trezm/dotty/docs/battery-40x30x8/bottom-loading-render.png

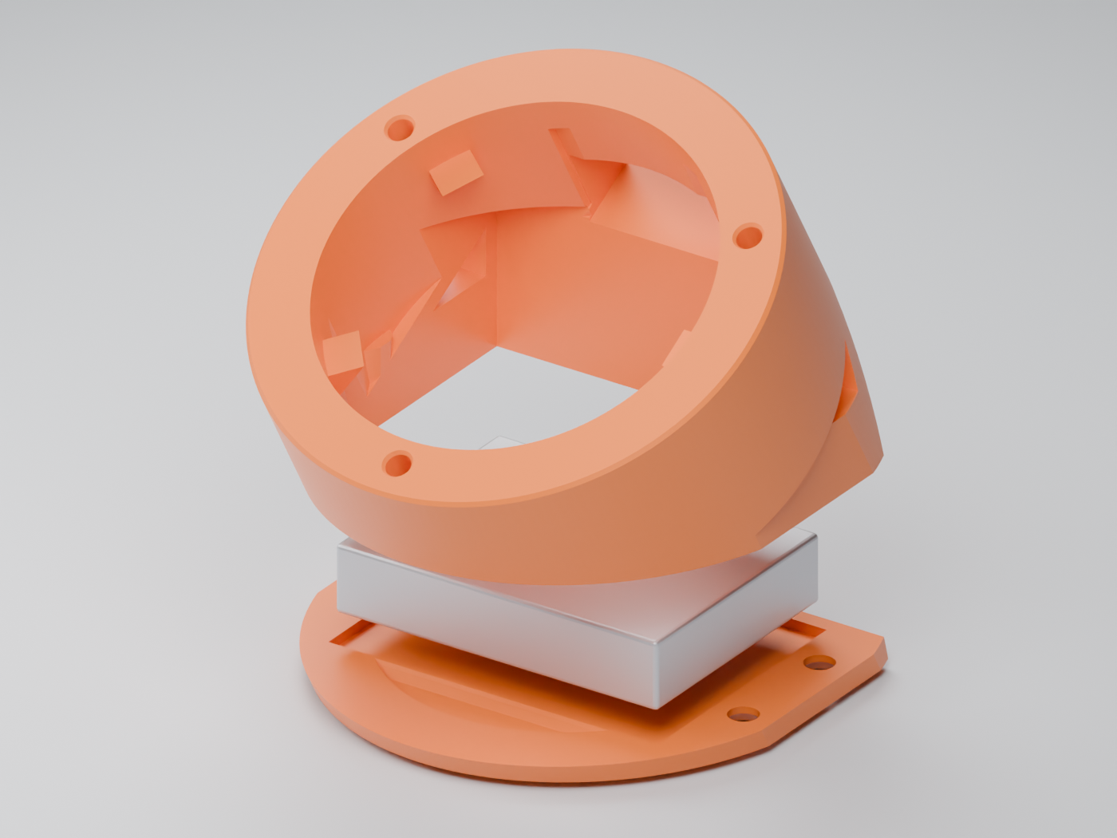
docs/battery-40x30x8/bottom-loading-render.png
