trezm/dotty/docs/battery-40x30x8/cutaway.png

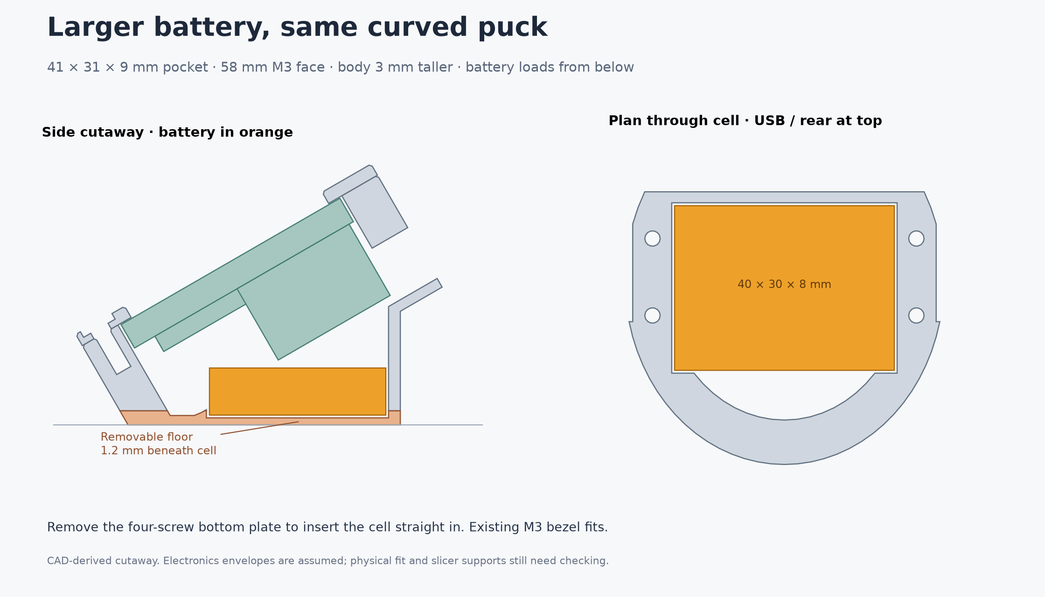
docs/battery-40x30x8/cutaway.png
