trezm/dotty/docs/battery-40x30x8/front-render.png

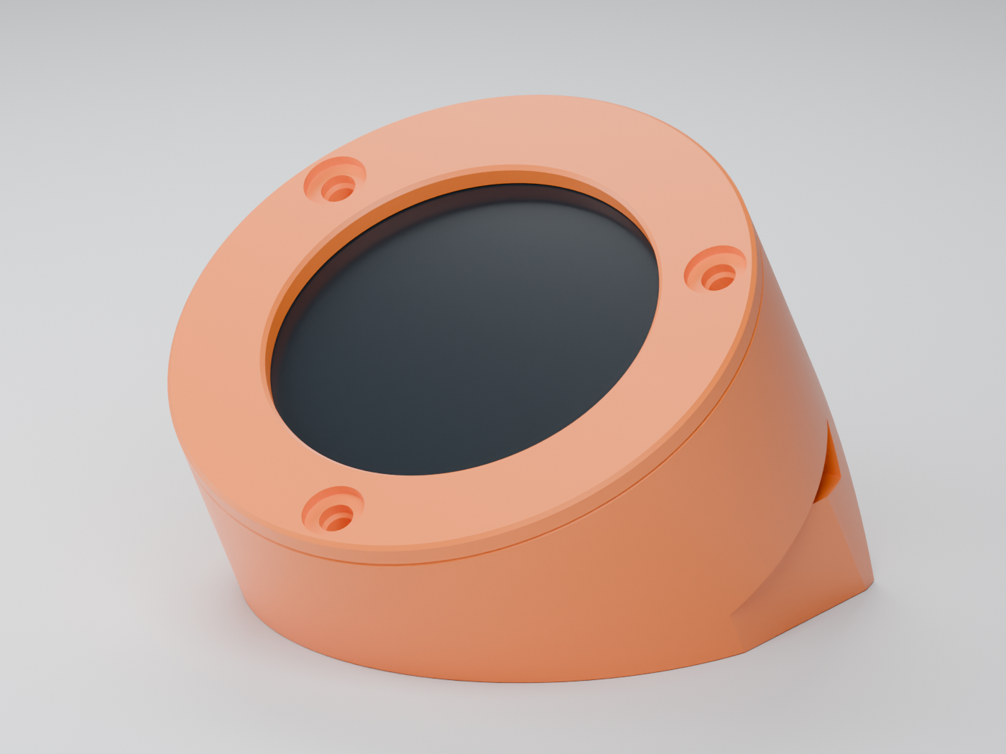
docs/battery-40x30x8/front-render.png
