trezm/dotty/docs/battery-disk/bottom-loading-render.png

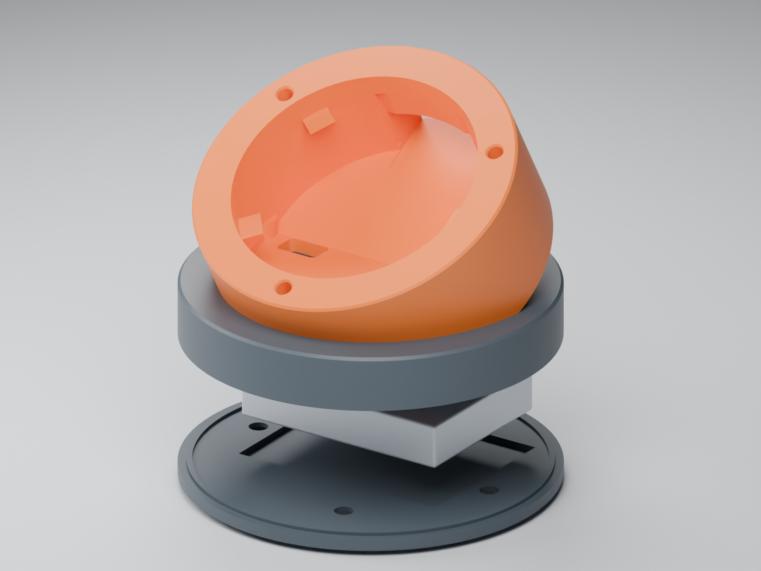
docs/battery-disk/bottom-loading-render.png
