trezm/dotty/docs/battery-disk/countersink-section.png

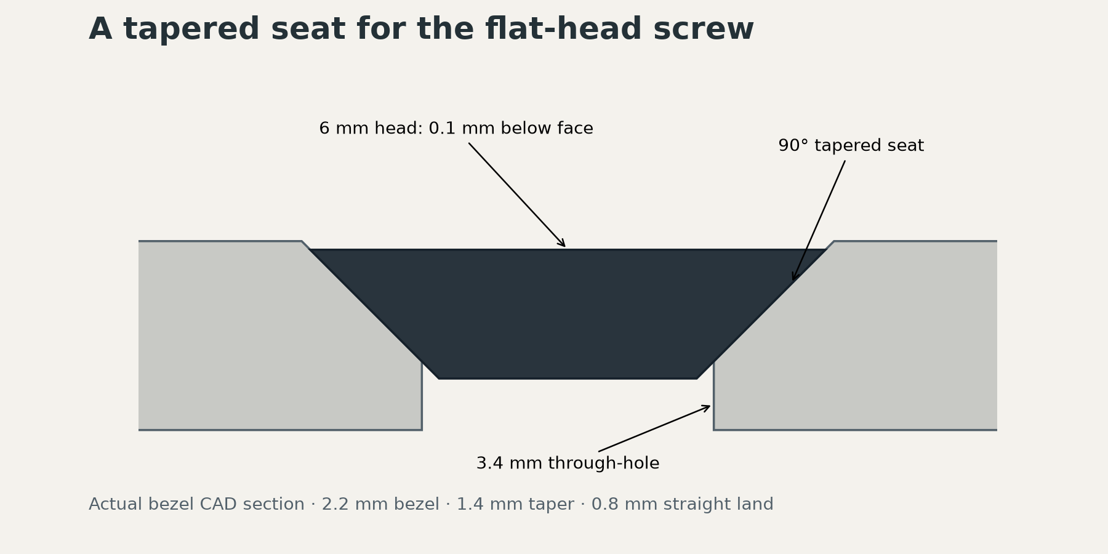
docs/battery-disk/countersink-section.png
