trezm/dotty/docs/battery-disk/countersink-stl-closeup.png

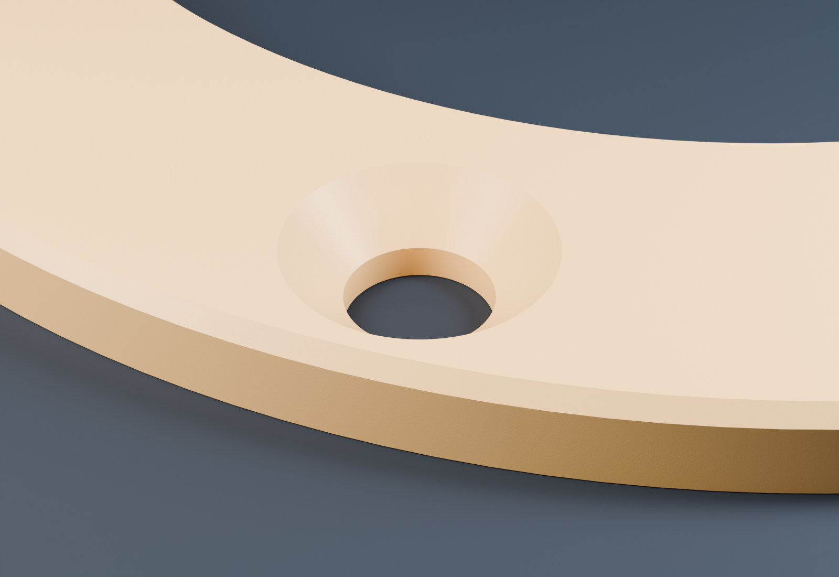
docs/battery-disk/countersink-stl-closeup.png
