trezm/dotty/docs/battery-disk/cutaway.png

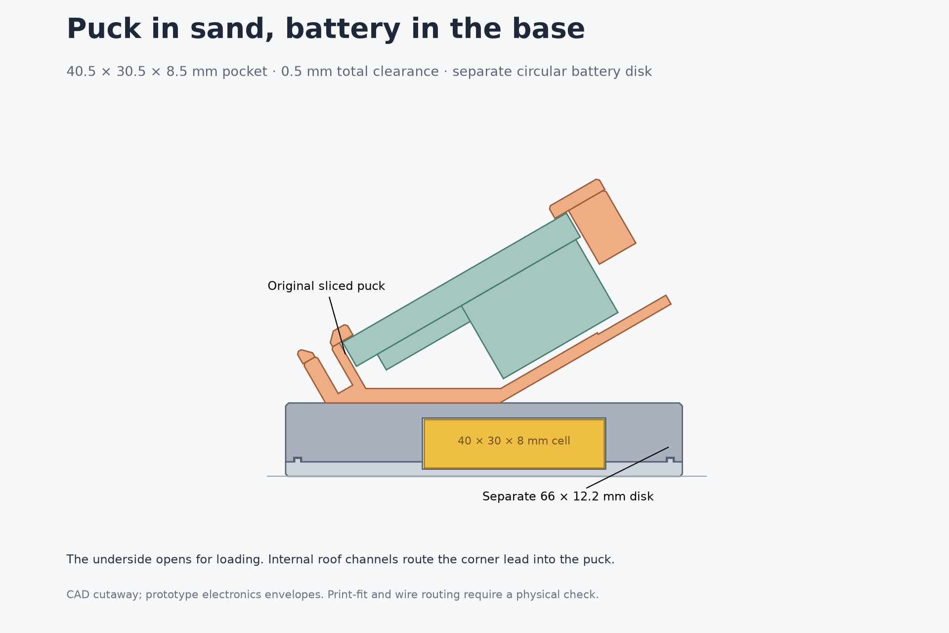
docs/battery-disk/cutaway.png
