trezm/dotty/docs/battery-disk/front-render.png

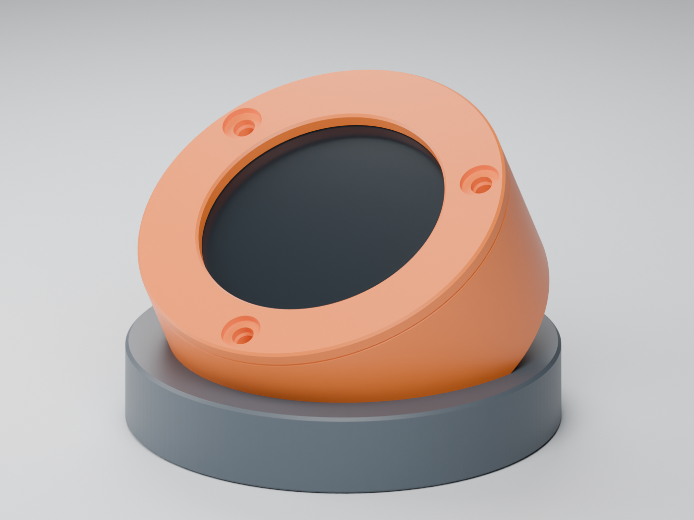
docs/battery-disk/front-render.png
