trezm/dotty/docs/battery-disk/side-render.png

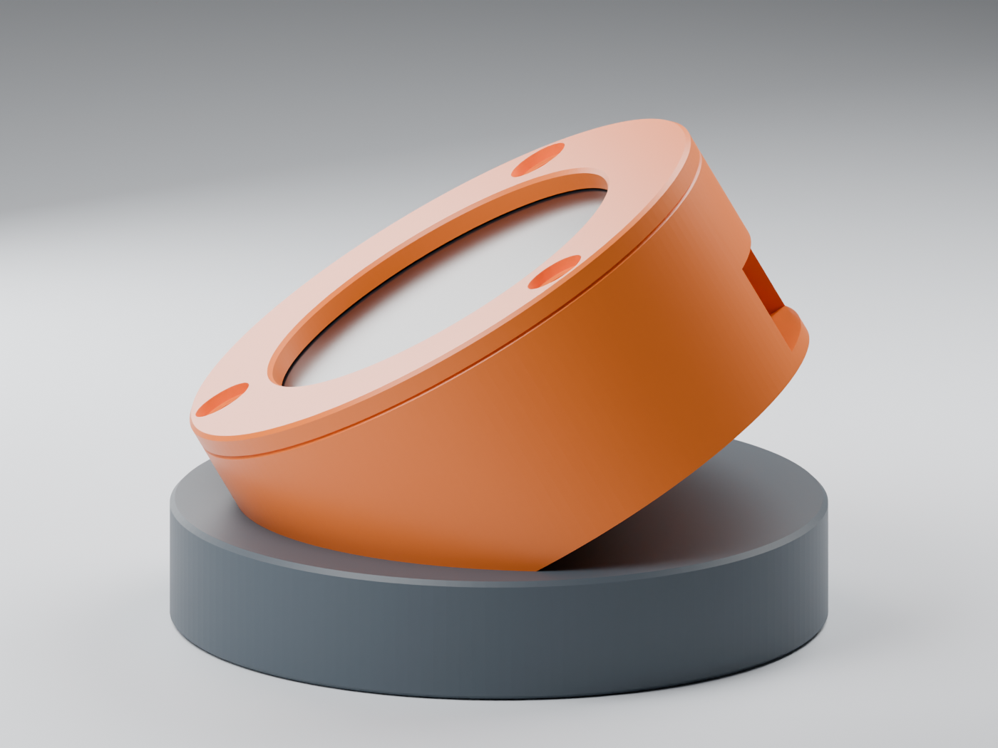
docs/battery-disk/side-render.png
