trezm/dotty/docs/battery-study/compact-base.png

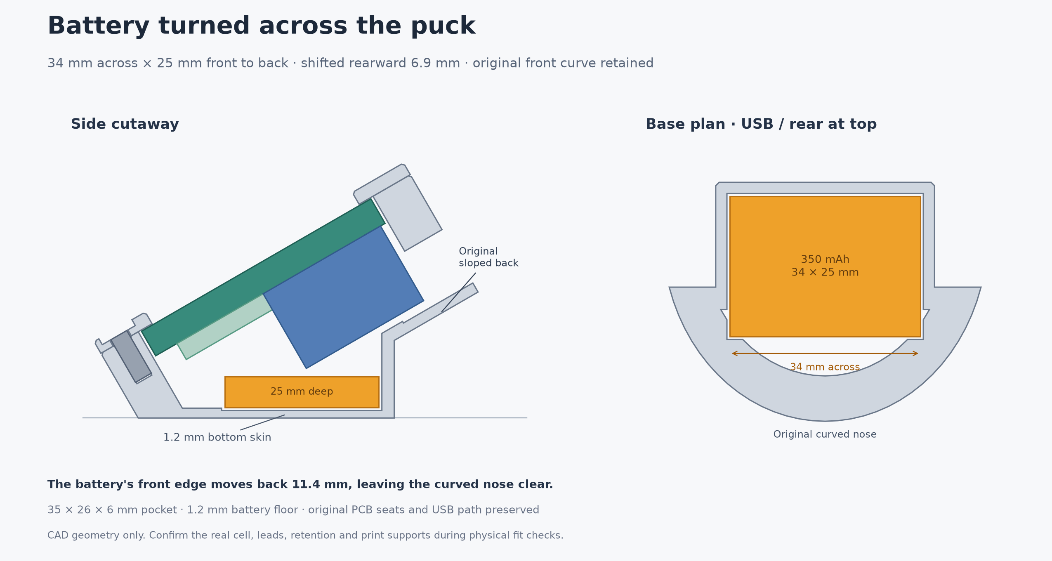
docs/battery-study/compact-base.png
