trezm/dotty/docs/battery-study/crosswise-front-render.png

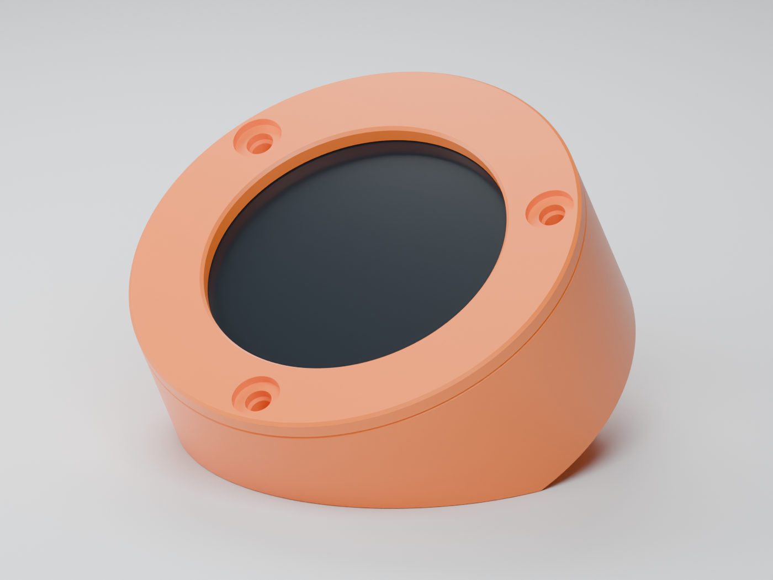
docs/battery-study/crosswise-front-render.png
