trezm/dotty/docs/battery-study/crosswise-open-render.png

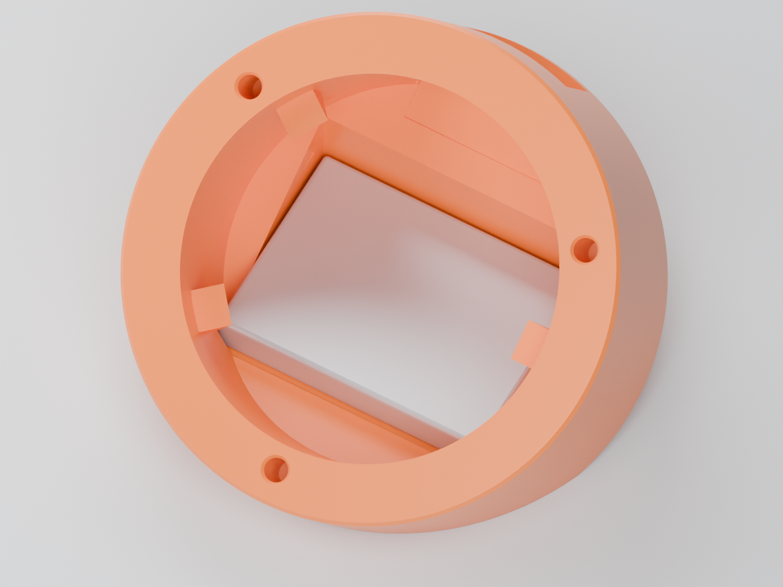
docs/battery-study/crosswise-open-render.png
