trezm/dotty/docs/battery-study/cutaway.png

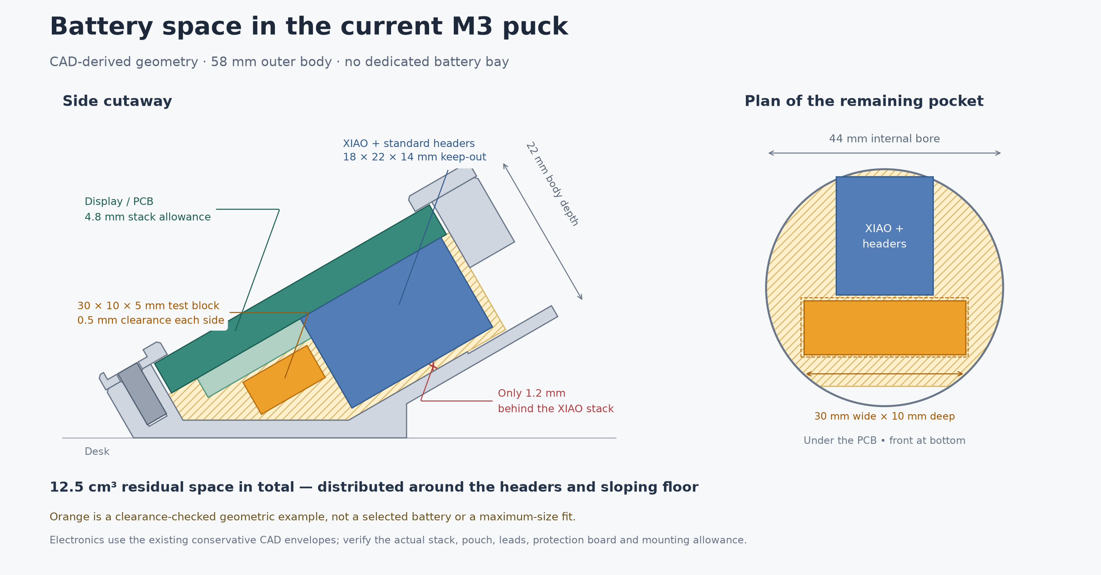
docs/battery-study/cutaway.png
