trezm/dotty/docs/battery-study/heel-proposal.png

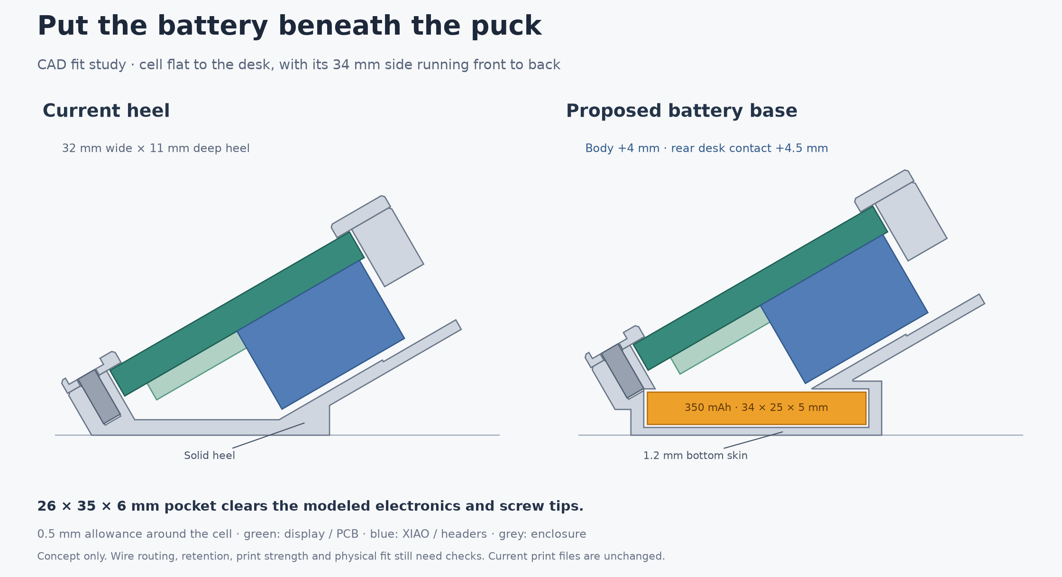
docs/battery-study/heel-proposal.png
