trezm/dotty/docs/battery-study/vertical-rear.png

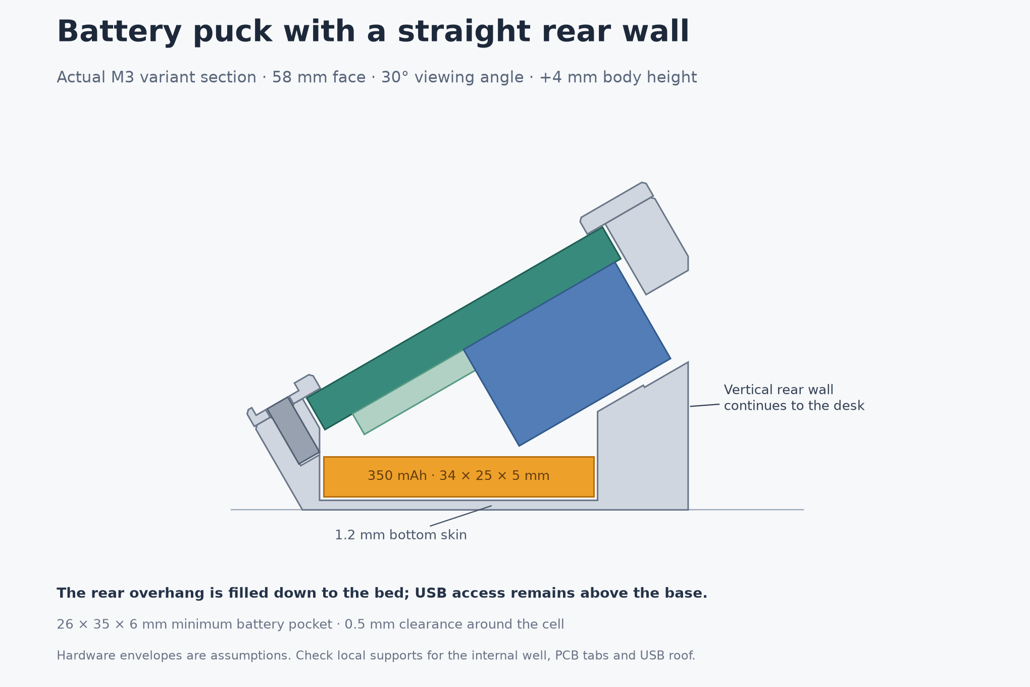
docs/battery-study/vertical-rear.png
