trezm/dotty/docs/color-studies-edgy/02-ultraviolet.png

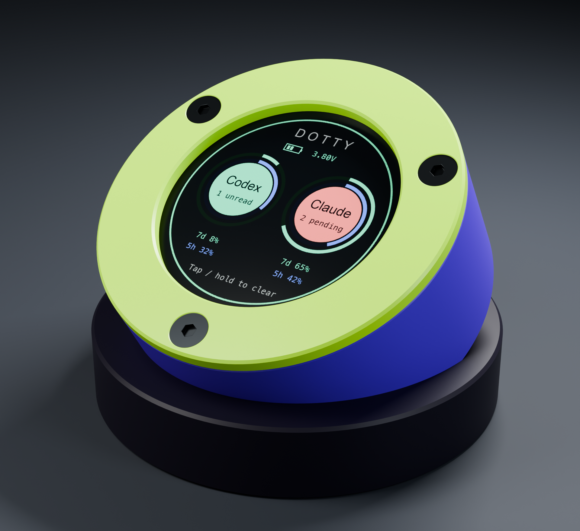
docs/color-studies-edgy/02-ultraviolet.png
