trezm/dotty/docs/color-studies-edgy/03-hotwire.png

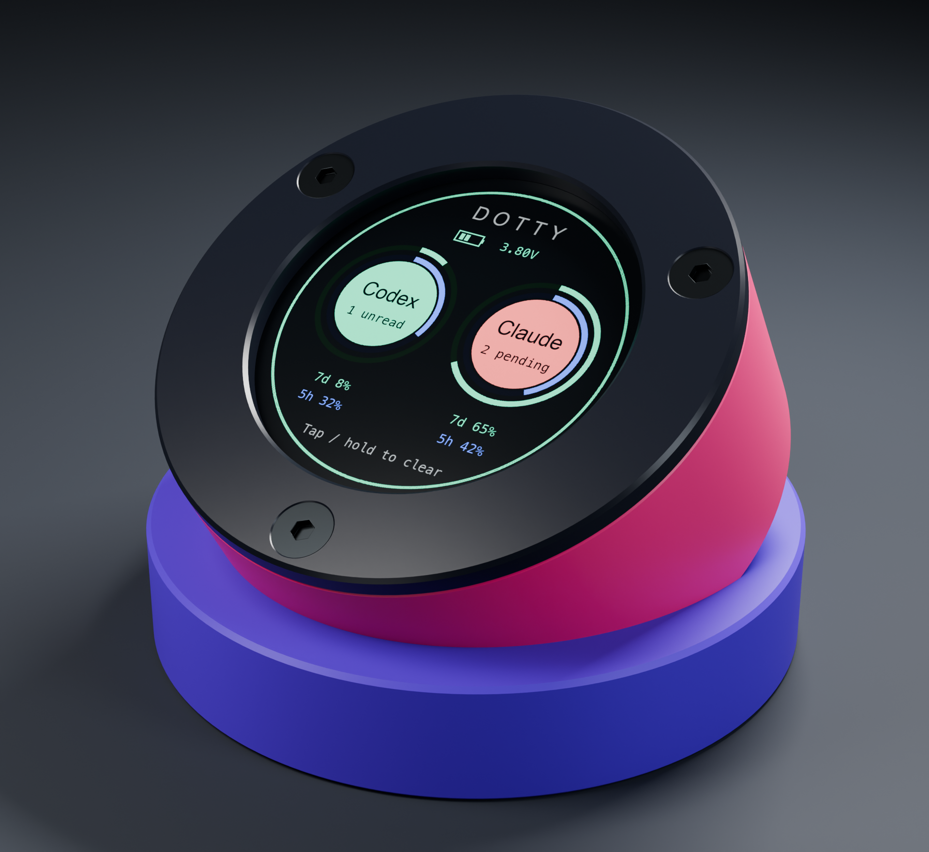
docs/color-studies-edgy/03-hotwire.png
