trezm/dotty/docs/color-studies-edgy/dotty-six-edgy-colorways.png

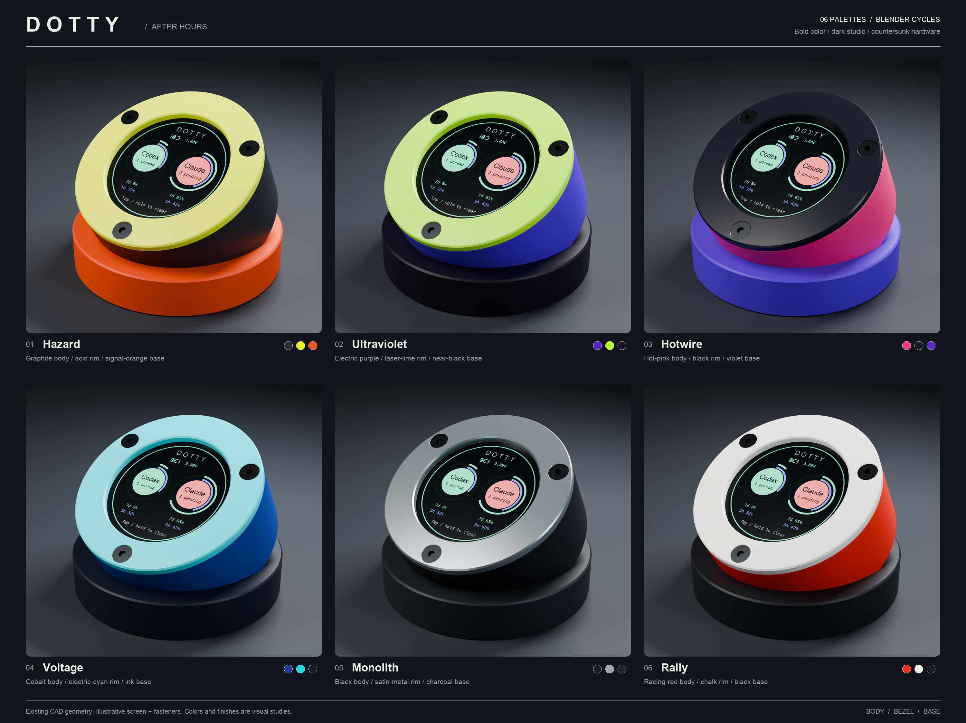
docs/color-studies-edgy/dotty-six-edgy-colorways.png
