trezm/dotty/docs/color-studies-zed/01-carbon-draft.png

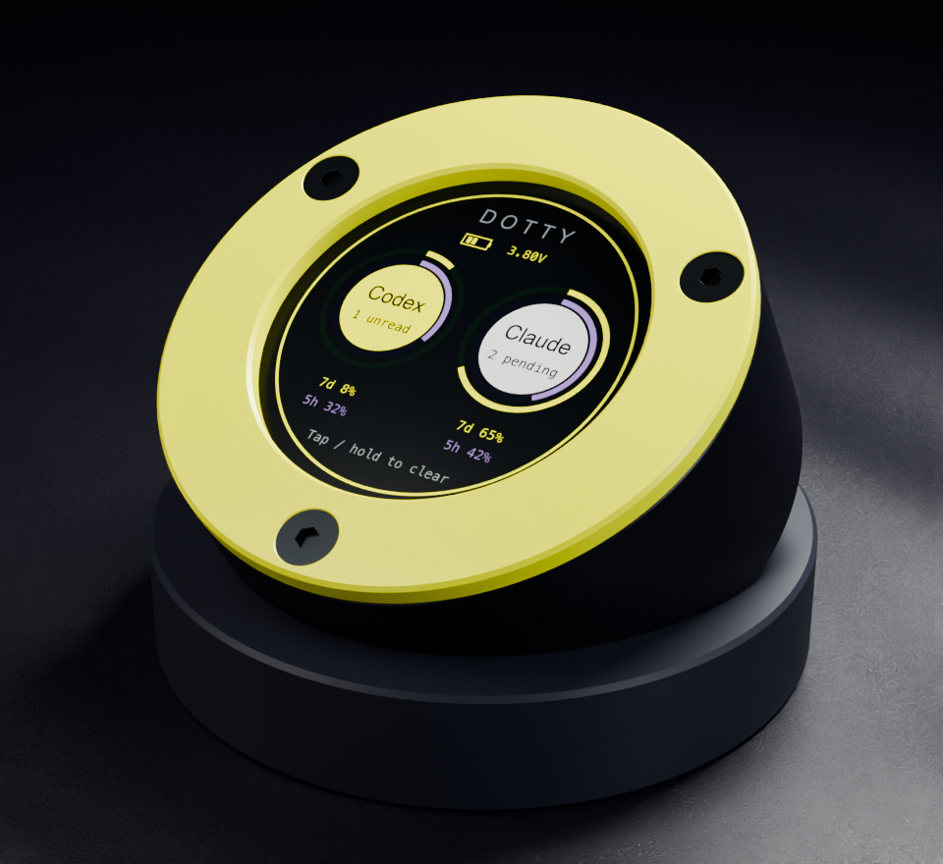
docs/color-studies-zed/01-carbon-draft.png
