trezm/dotty/docs/color-studies-zed/02-dayglow.png

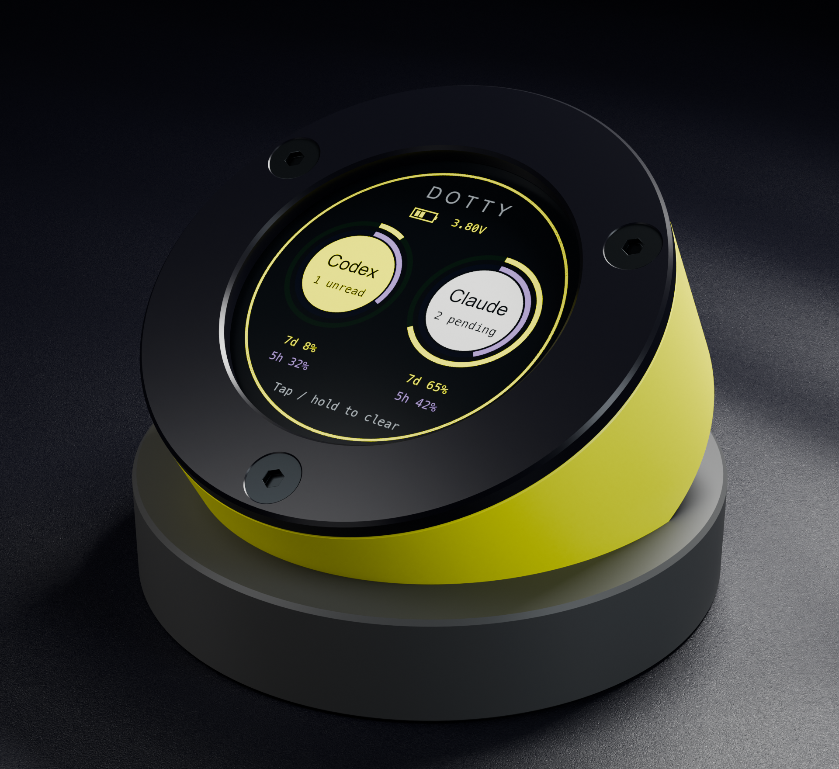
docs/color-studies-zed/02-dayglow.png
