trezm/dotty/docs/color-studies-zed/03-titanium.png

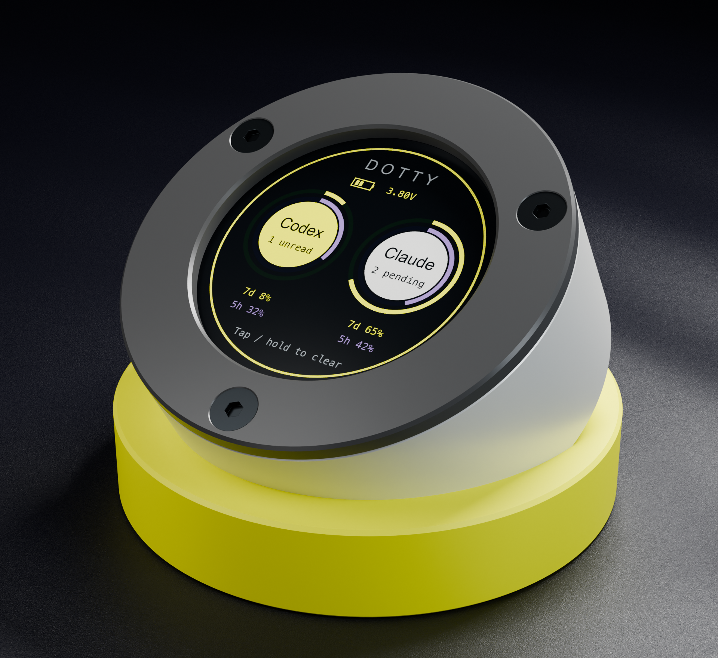
docs/color-studies-zed/03-titanium.png
