trezm/dotty/docs/color-studies-zed/04-amethyst.png

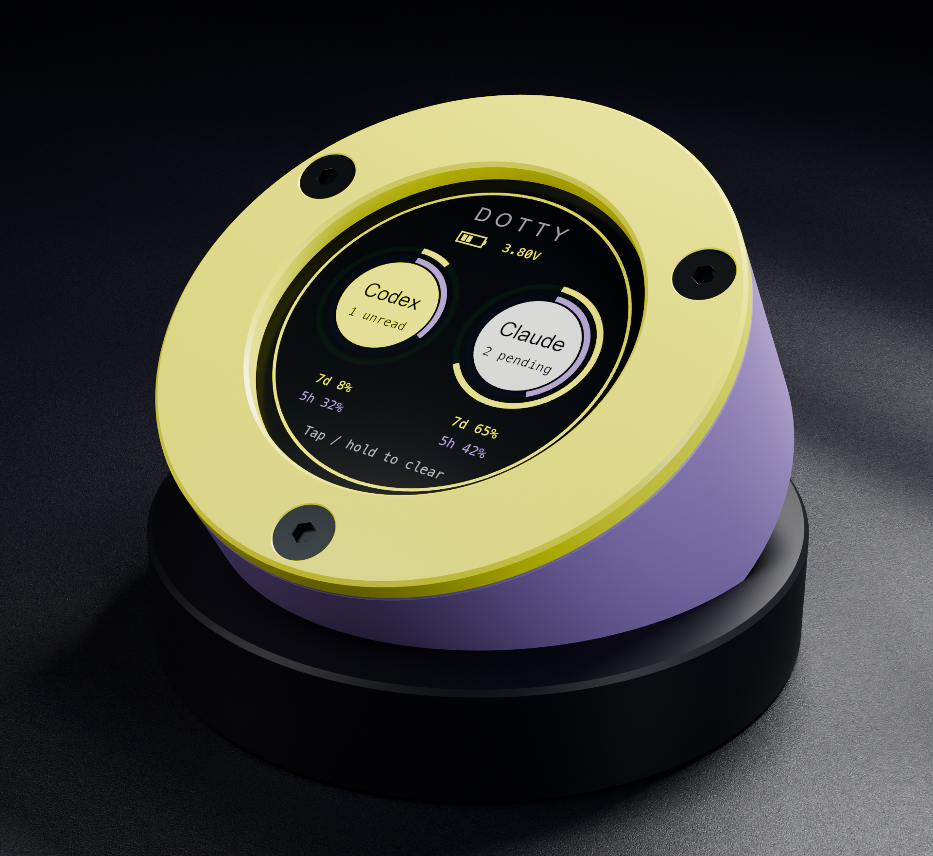
docs/color-studies-zed/04-amethyst.png
