trezm/dotty/docs/color-studies-zed/dotty-zed-colorways.png

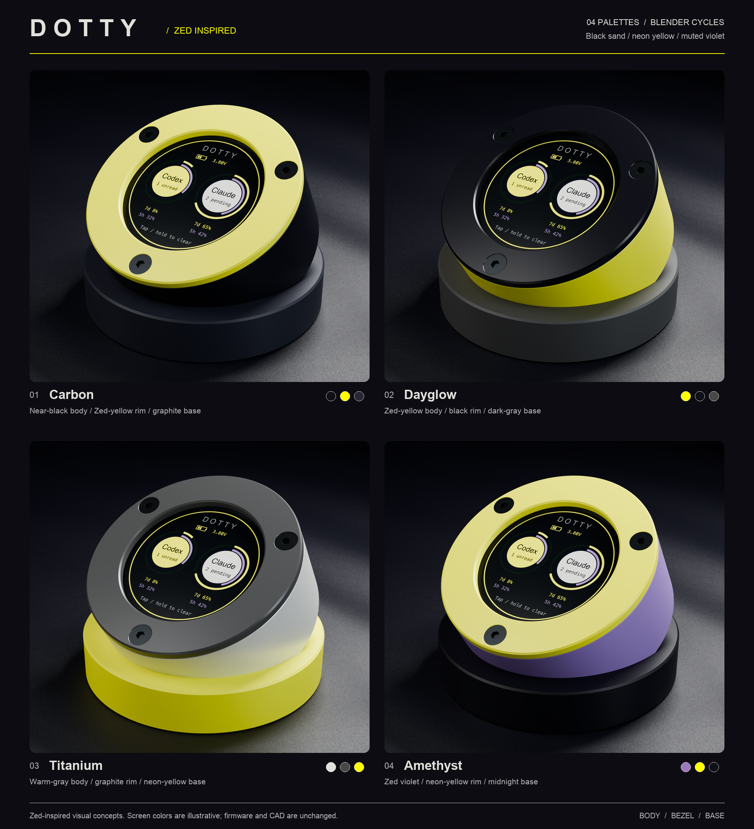
docs/color-studies-zed/dotty-zed-colorways.png
