trezm/dotty/docs/color-studies-zed/zed-dashboard-concept.png

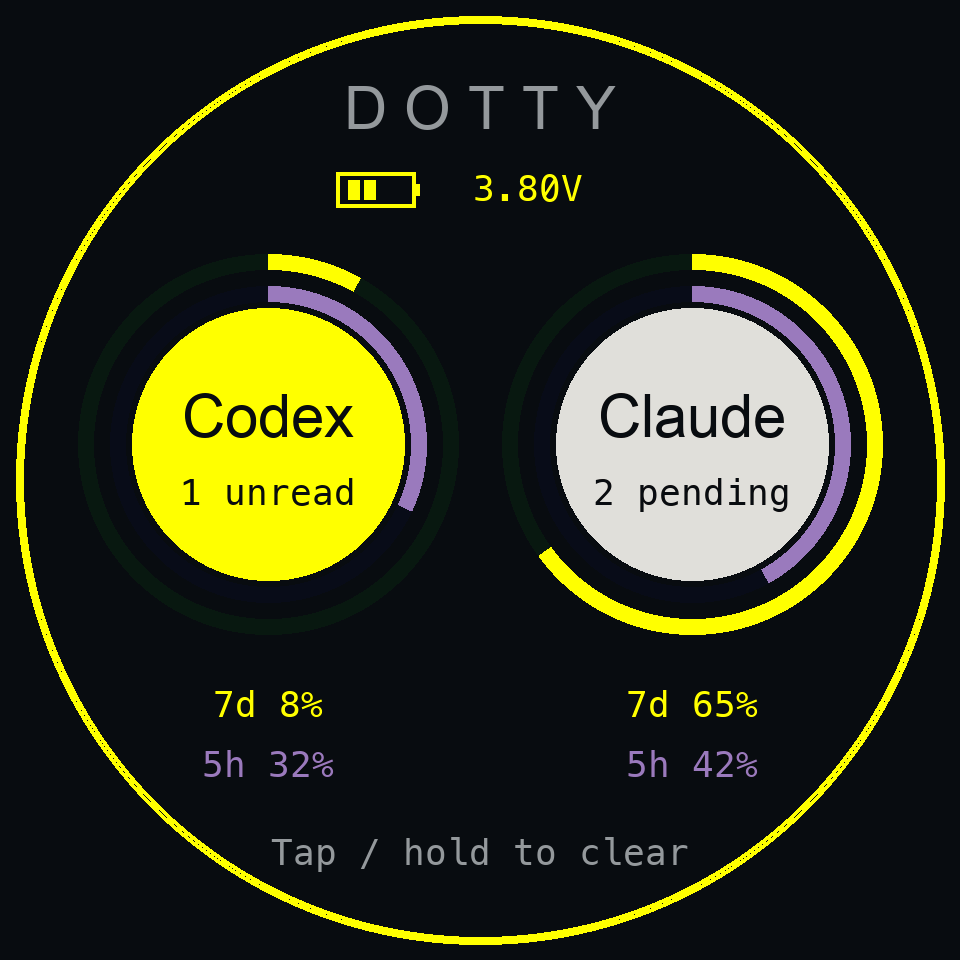
docs/color-studies-zed/zed-dashboard-concept.png
