trezm/dotty/docs/color-studies/01-clay-ink-draft.png

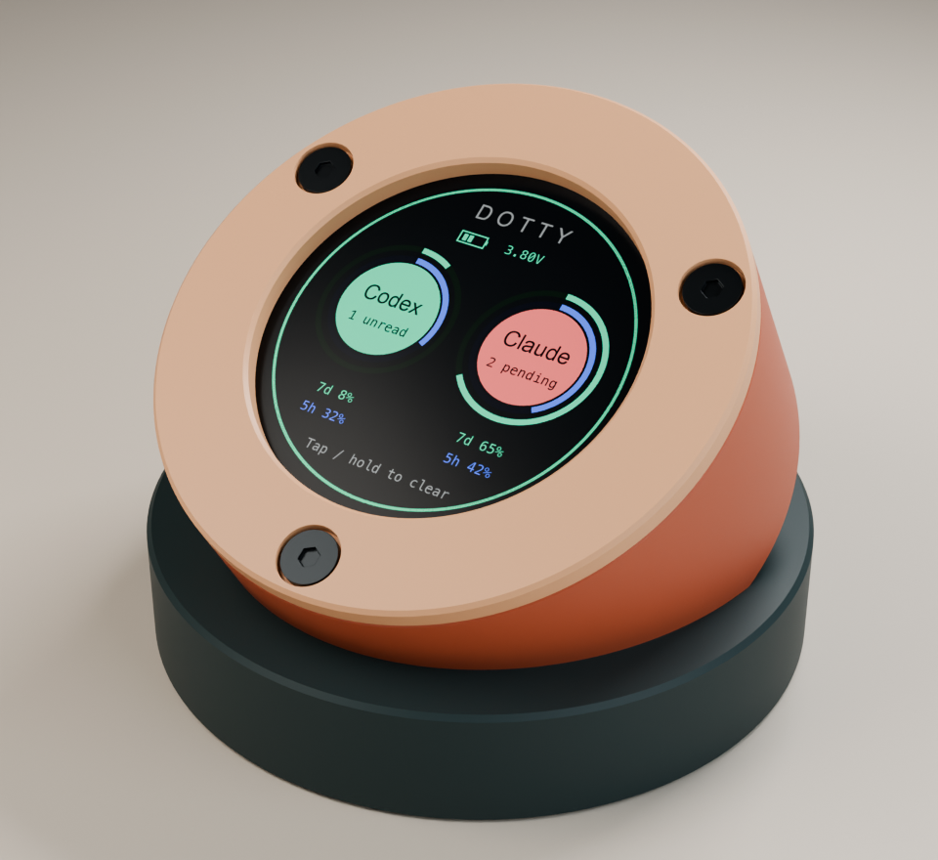
docs/color-studies/01-clay-ink-draft.png
