trezm/dotty/docs/color-studies/04-violet-hour.png

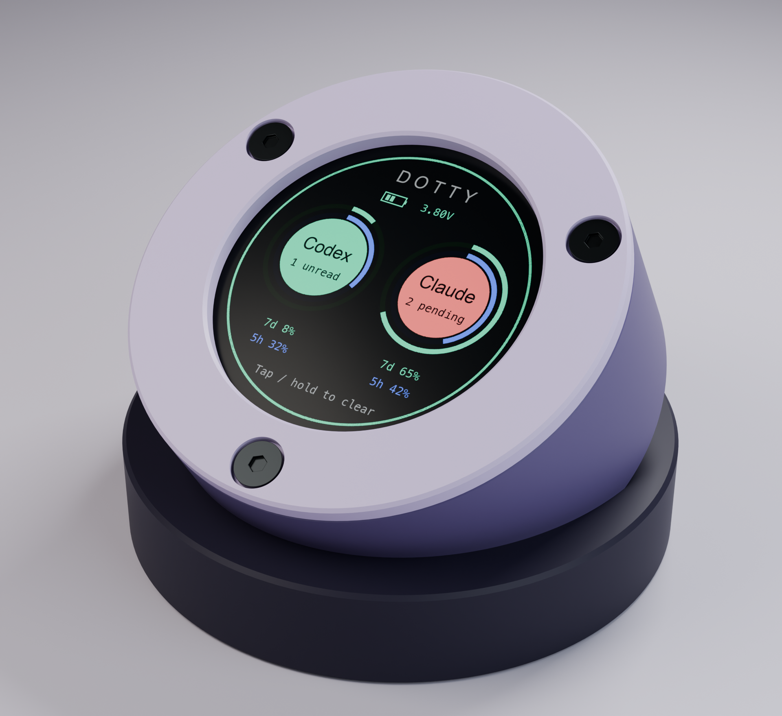
docs/color-studies/04-violet-hour.png
