trezm/dotty/docs/color-studies/05-porcelain.png

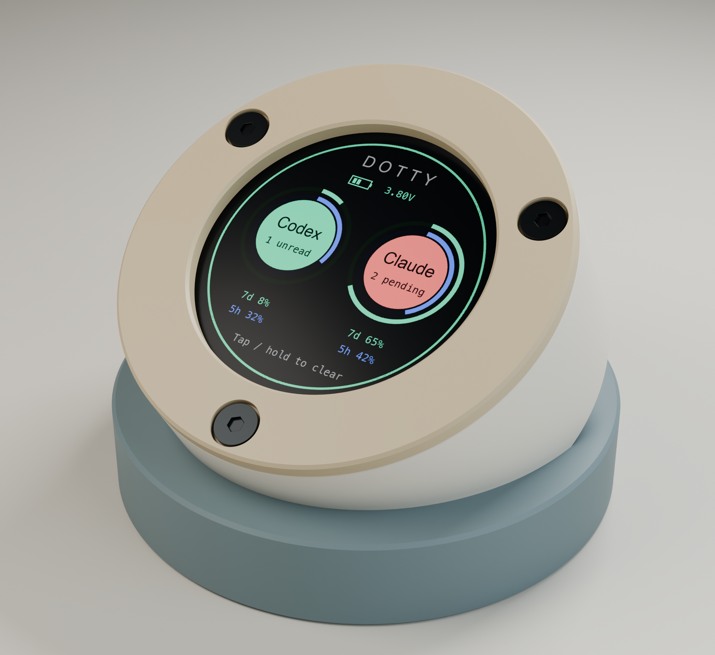
docs/color-studies/05-porcelain.png
