trezm/dotty/docs/color-studies/06-acid-graphite.png

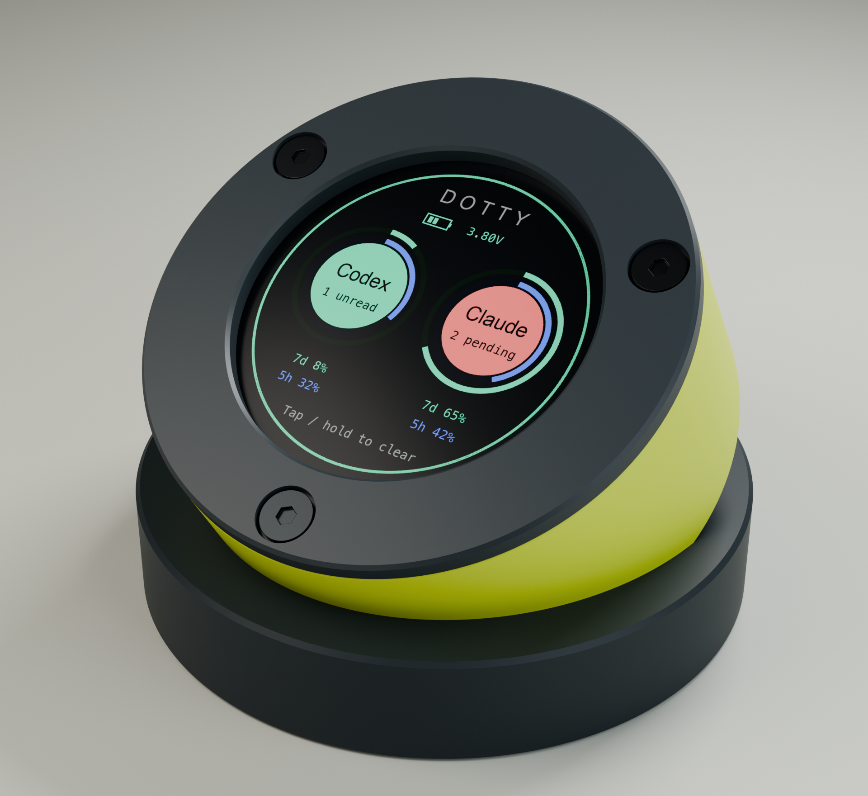
docs/color-studies/06-acid-graphite.png
