trezm/dotty/docs/color-studies/dotty-six-colorways.png

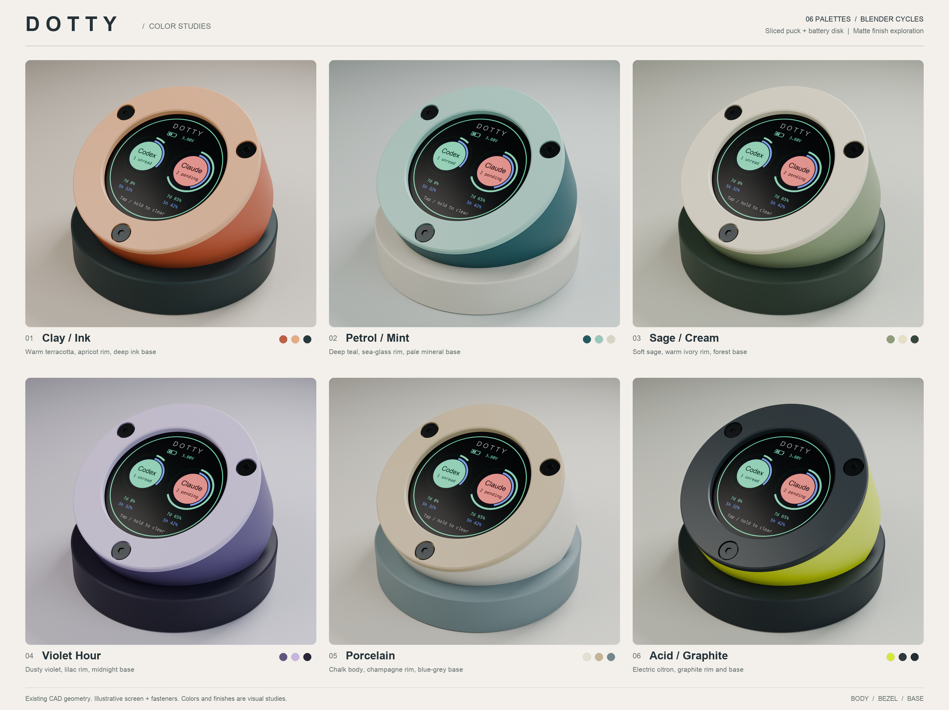
docs/color-studies/dotty-six-colorways.png
