trezm/dotty/docs/display-preview.png

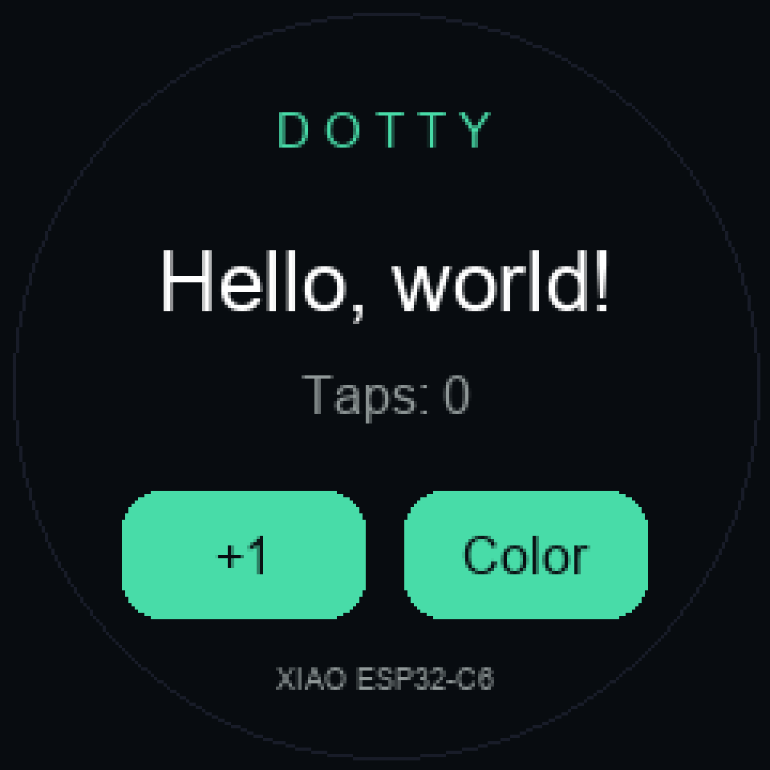
docs/display-preview.png
