trezm/dotty/docs/eyes/dotty-eyes-poster.png

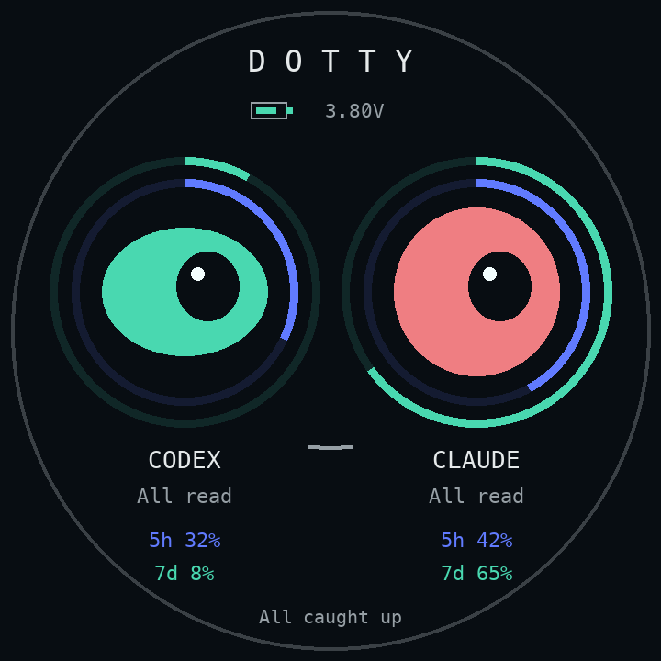
docs/eyes/dotty-eyes-poster.png
