trezm/dotty/docs/eyes/dotty-eyes-storyboard.png

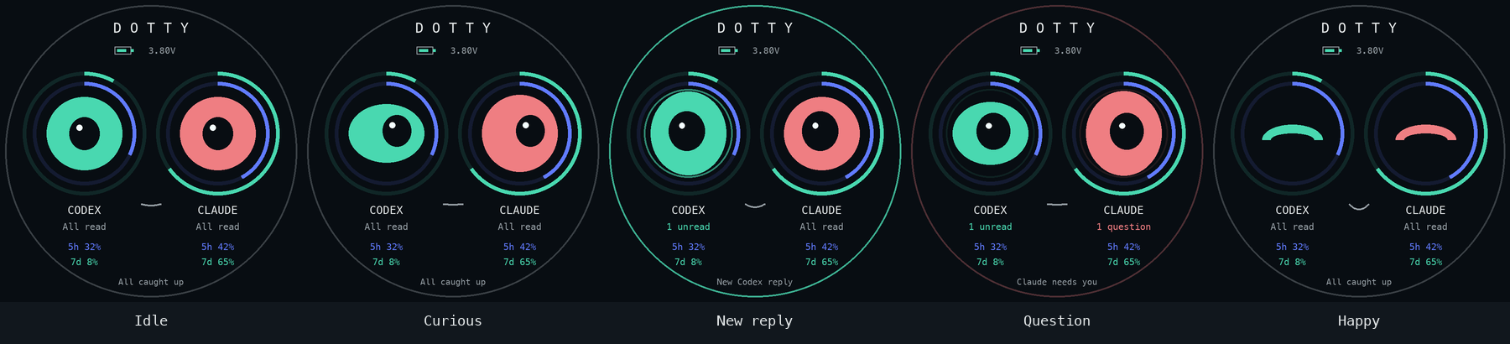
docs/eyes/dotty-eyes-storyboard.png
