trezm/dotty/docs/eyes/dotty-vector-eyes-poster.png

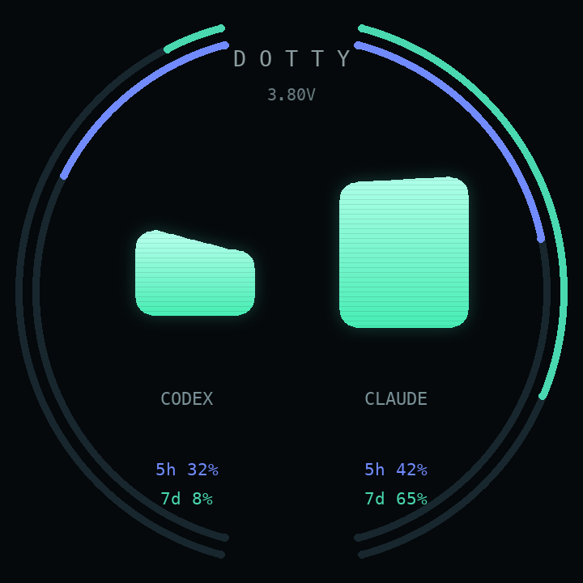
docs/eyes/dotty-vector-eyes-poster.png
