trezm/dotty/docs/eyes/dotty-vector-eyes-storyboard.png

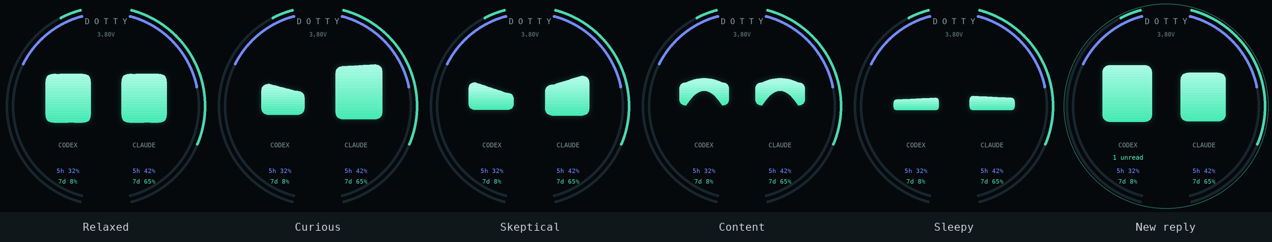
docs/eyes/dotty-vector-eyes-storyboard.png
