trezm/dotty/docs/eyes/dotty-vector-eyes.gif

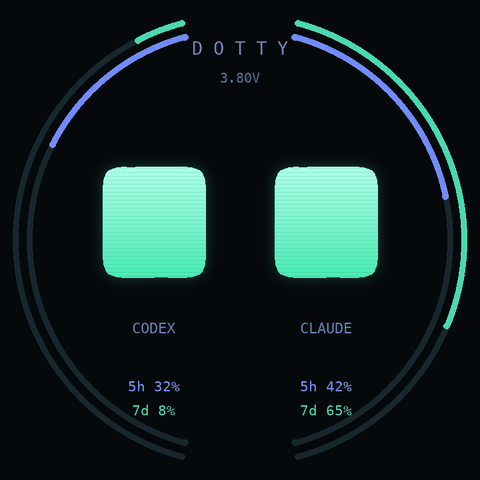
docs/eyes/dotty-vector-eyes.gif
