trezm/dotty/cad/variants/m3-battery/exports/assembly.step

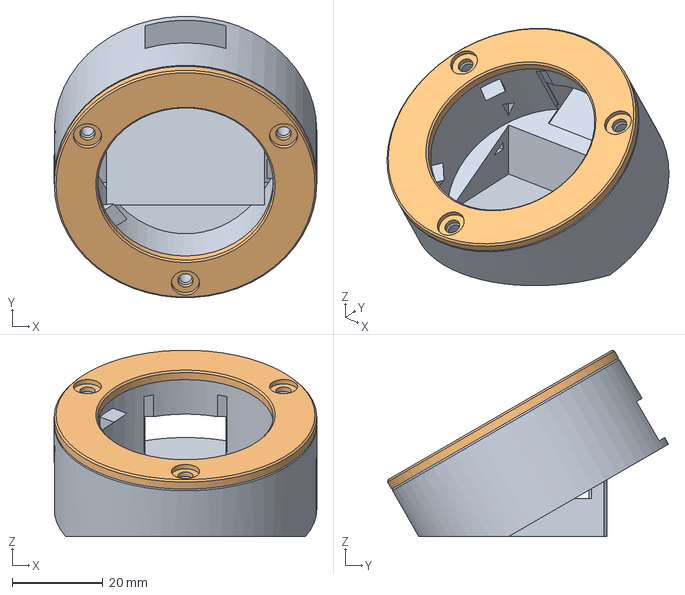
[picture p40: CAD file, 2026-11-11]
cad/variants/m3-battery/exports/assembly.step
58.0 x 62.1 x 41.2 mm
bezel
