trezm/dotty/cad/variants/m3-battery-disk/exports/assembly.step

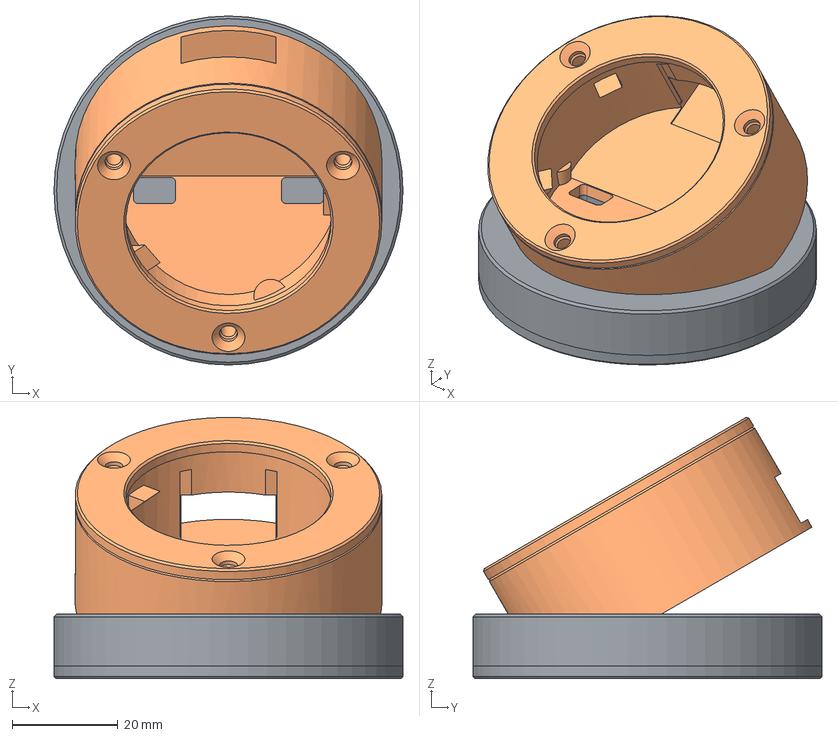
[picture p41: CAD file, 2026-11-11]
cad/variants/m3-battery-disk/exports/assembly.step
66.0 x 66.0 x 49.4 mm
puck-body
base-disk
battery-cover
bezel
