trezm/dotty/cad/exports/assembly.step

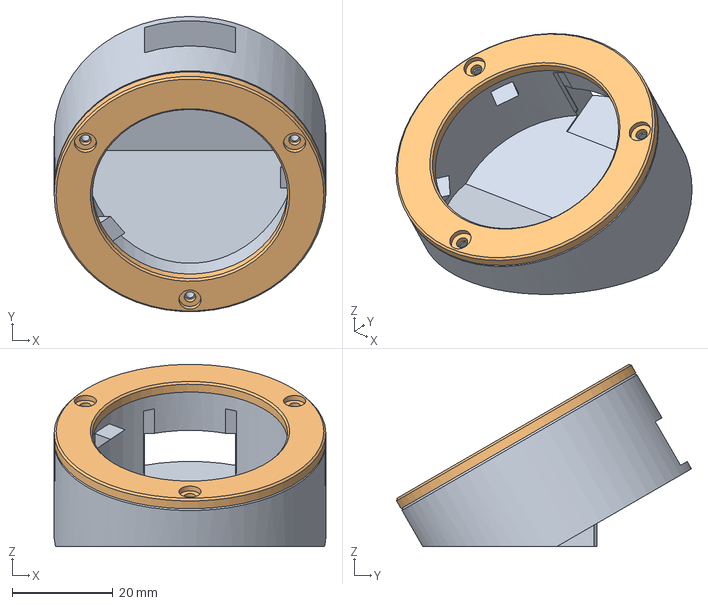
[picture p42: CAD file, 2026-11-11]
cad/exports/assembly.step
54.0 x 58.6 x 36.2 mm
bezel
