trezm/dotty/dotty-m3-battery/assembly.step

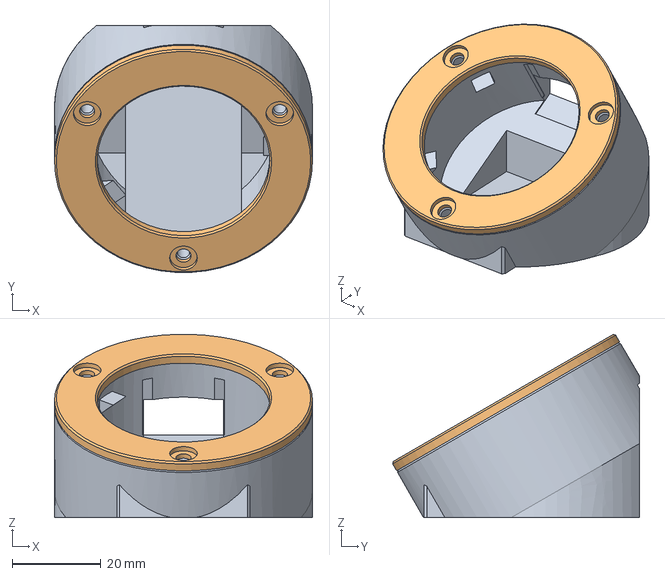
[picture p43: CAD file, 2026-11-11]
dotty-m3-battery/assembly.step
58.0 x 55.5 x 41.2 mm
bezel
