trezm/dotty/cad/variants/m3-battery-40x30x8/exports/assembly.step

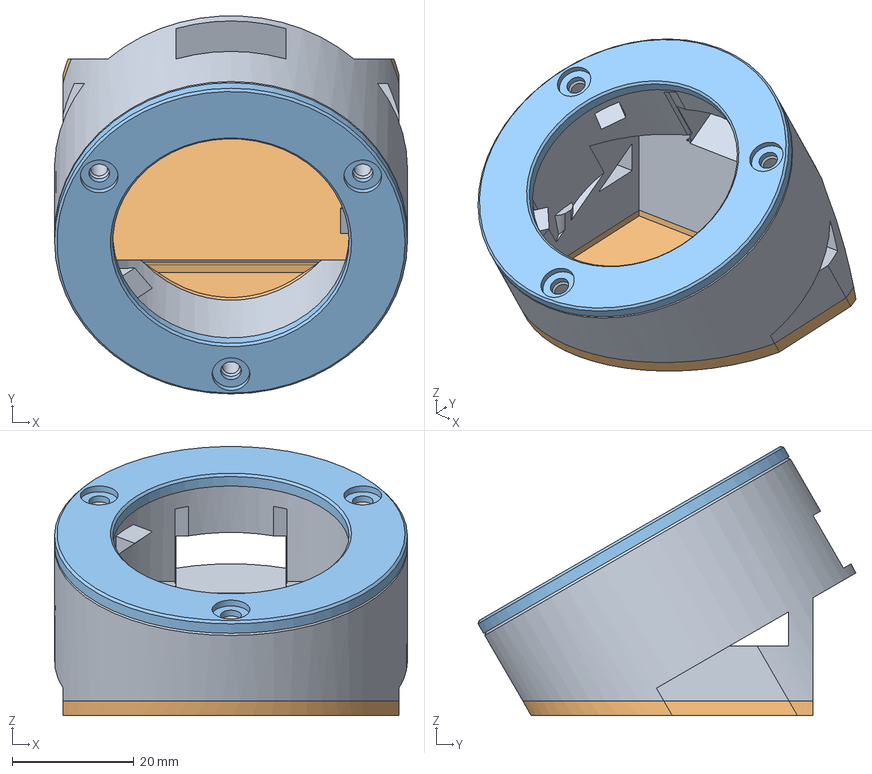
[picture p44: CAD file, 2026-11-11]
cad/variants/m3-battery-40x30x8/exports/assembly.step
58.0 x 62.1 x 44.2 mm
battery-cover
bezel
