trezm/dotty/cad/variants/m3-machine/exports/assembly.step

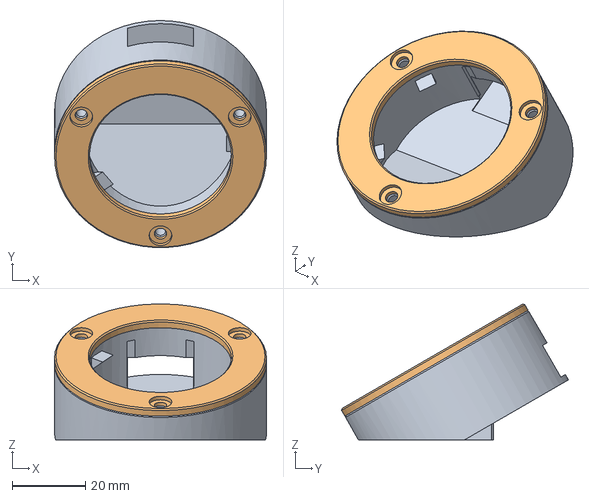
[picture p45: CAD file, 2026-11-11]
cad/variants/m3-machine/exports/assembly.step
58.0 x 62.1 x 37.2 mm
bezel
