trezm/dotty/cad/exports/bezel.step

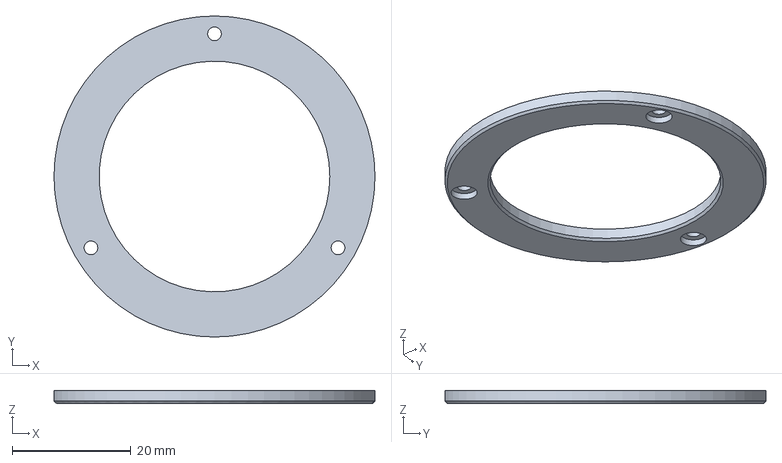
[picture p46: CAD file, 2026-11-11]
cad/exports/bezel.step
54.0 x 54.0 x 2.20 mm
