trezm/dotty/cad/variants/m3-battery-40x30x8/exports/fit-ring.step

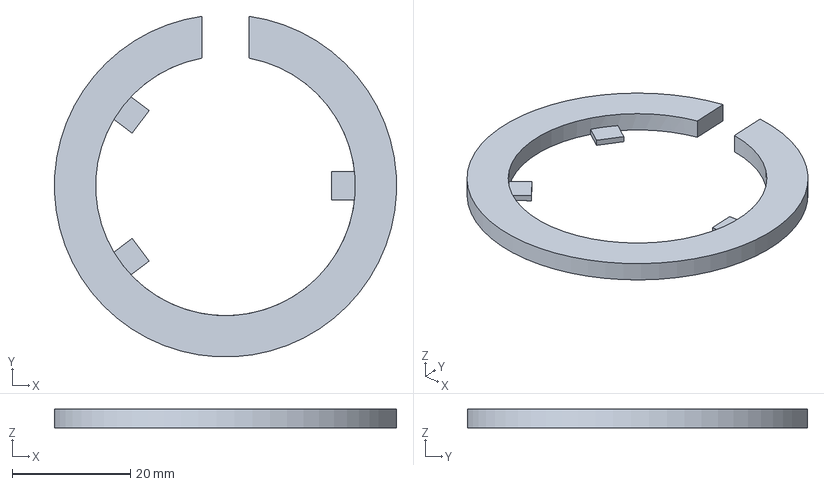
[picture p47: CAD file, 2026-11-11]
cad/variants/m3-battery-40x30x8/exports/fit-ring.step
57.9 x 57.7 x 3.20 mm
