trezm/dotty/cad/variants/m3-battery-disk/exports/countersink-fit.step

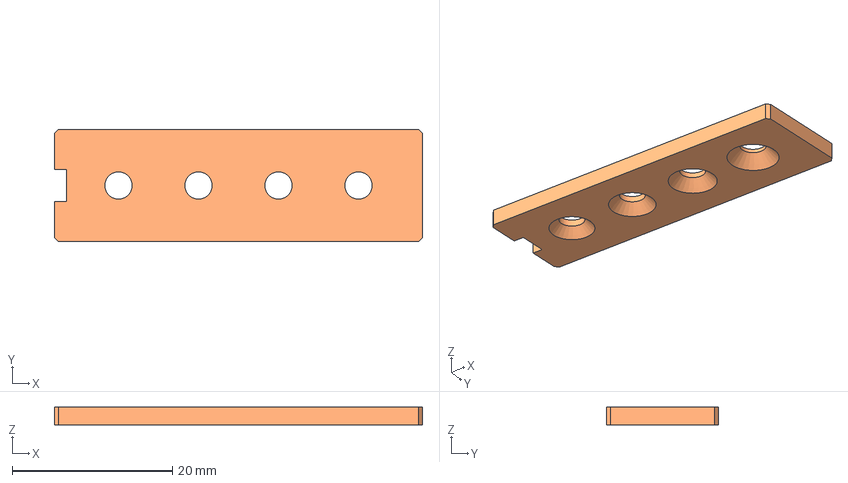
[picture p48: CAD file, 2026-11-11]
cad/variants/m3-battery-disk/exports/countersink-fit.step
46.0 x 14.0 x 2.20 mm
