trezm/dotty/dotty-bezel-M3-countersunk-90deg.stl

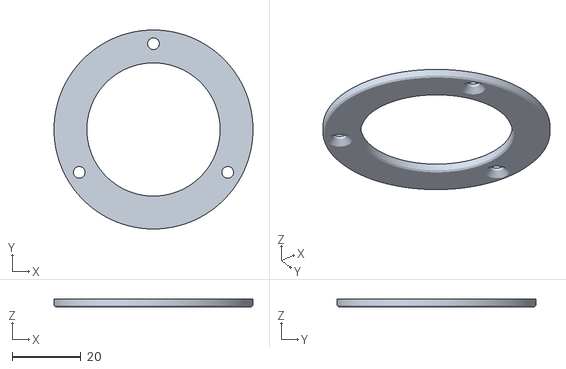
[picture p49: CAD file, 2026-11-11]
dotty-bezel-M3-countersunk-90deg.stl
58.0 x 58.0 x 2.20
