trezm/dotty/dotty-m3-battery 2/fit-test.stl

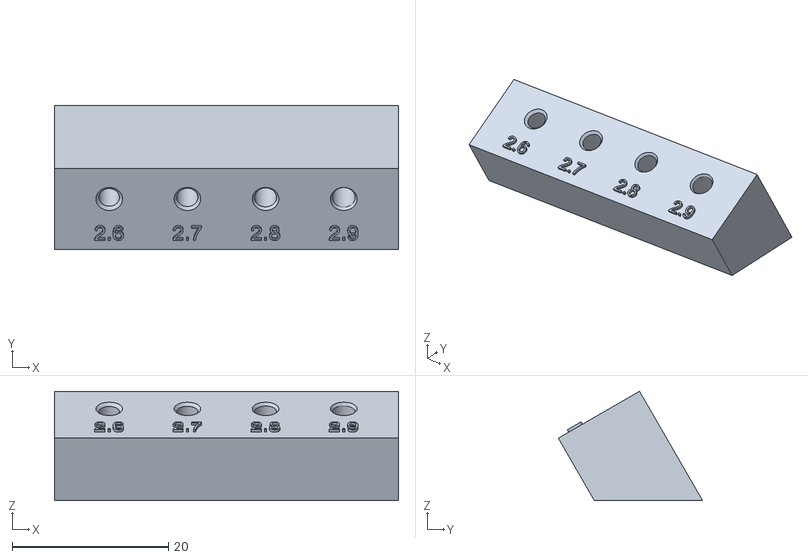
[picture p50: CAD file, 2026-11-11]
dotty-m3-battery 2/fit-test.stl
44.0 x 18.5 x 14.0
