trezm/dotty/dotty-m3-battery-disk/puck-body.step

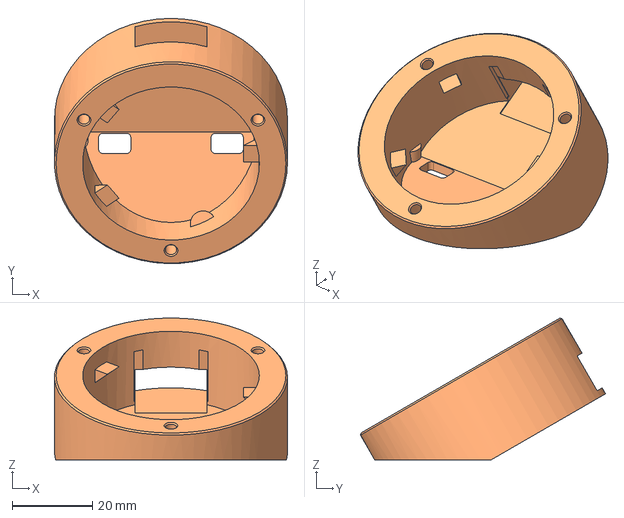
[picture p51: CAD file, 2026-11-11]
dotty-m3-battery-disk/puck-body.step
58.0 x 61.0 x 35.3 mm
