trezm/dotty/dotty-m3-battery/body.step

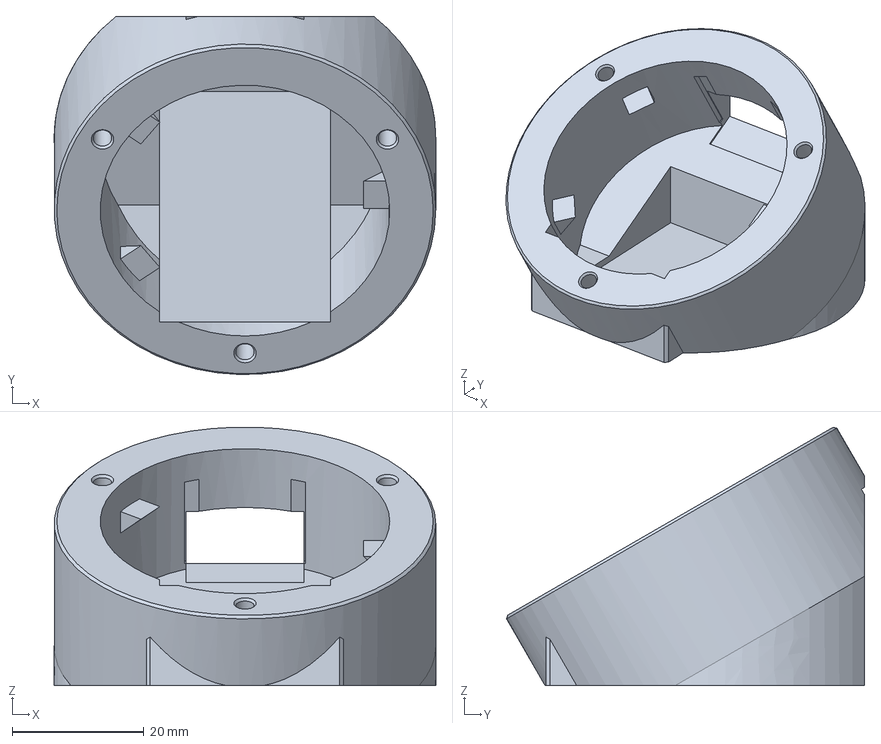
[picture p52: CAD file, 2026-11-11]
dotty-m3-battery/body.step
58.0 x 54.4 x 39.3 mm
