trezm/dotty/cad/exports/fit-ring.step

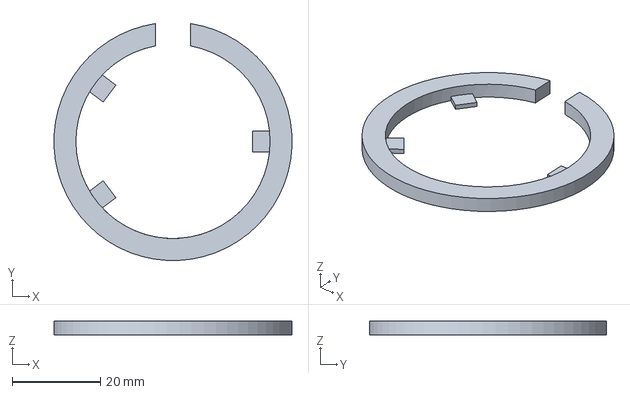
[picture p53: CAD file, 2026-11-11]
cad/exports/fit-ring.step
53.9 x 53.7 x 3.20 mm
