trezm/dotty/cad/variants/m3-battery-40x30x8/exports/body.step

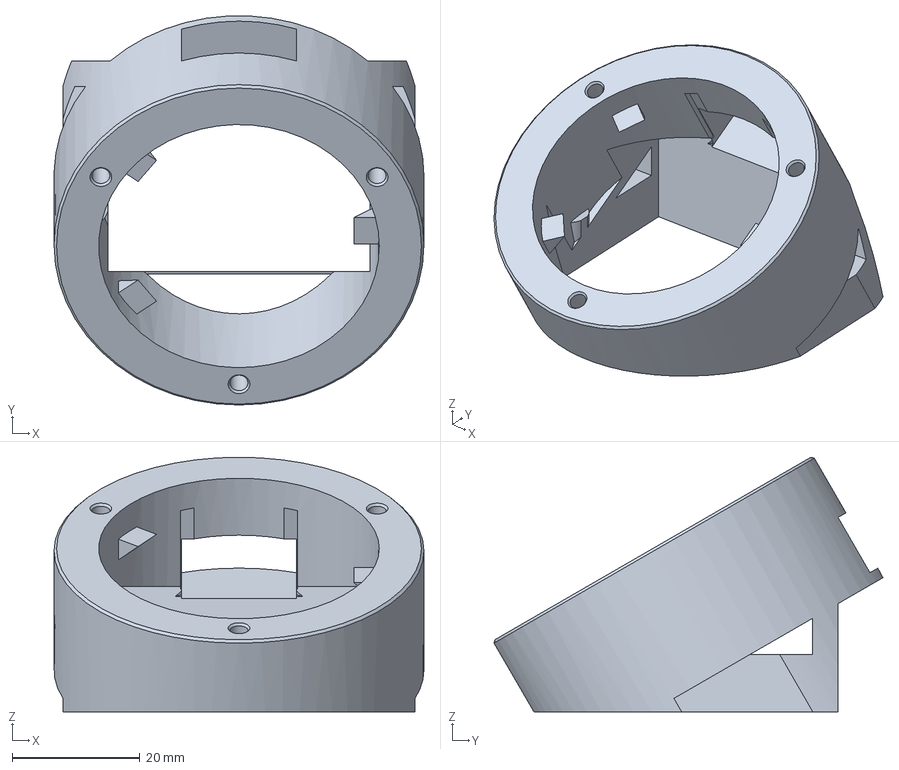
[picture p54: CAD file, 2026-11-11]
cad/variants/m3-battery-40x30x8/exports/body.step
58.0 x 61.0 x 39.9 mm
