trezm/dotty/cad/variants/m3-battery/exports/bezel.step

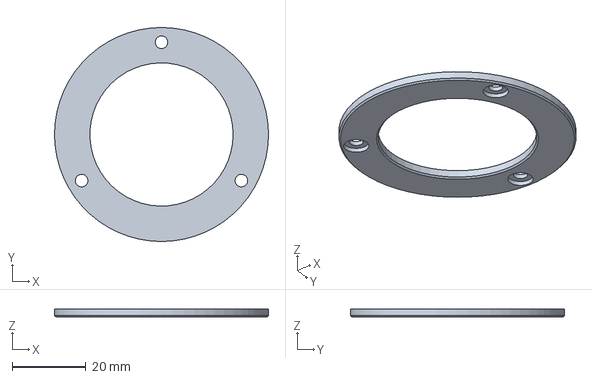
[picture p55: CAD file, 2026-11-11]
cad/variants/m3-battery/exports/bezel.step
58.0 x 58.0 x 2.20 mm
