trezm/dotty/dotty-m3-battery-disk/battery-cover.step

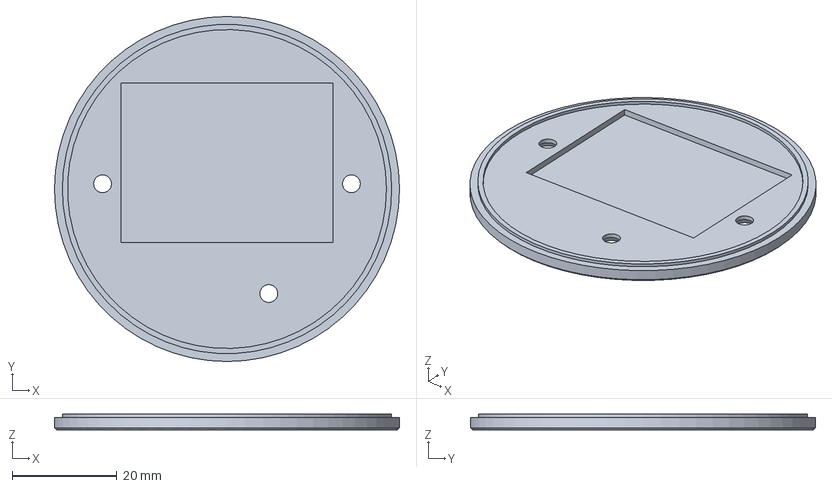
[picture p56: CAD file, 2026-11-11]
dotty-m3-battery-disk/battery-cover.step
66.0 x 66.0 x 3.00 mm
