trezm/dotty/dotty-print-kit/body.stl

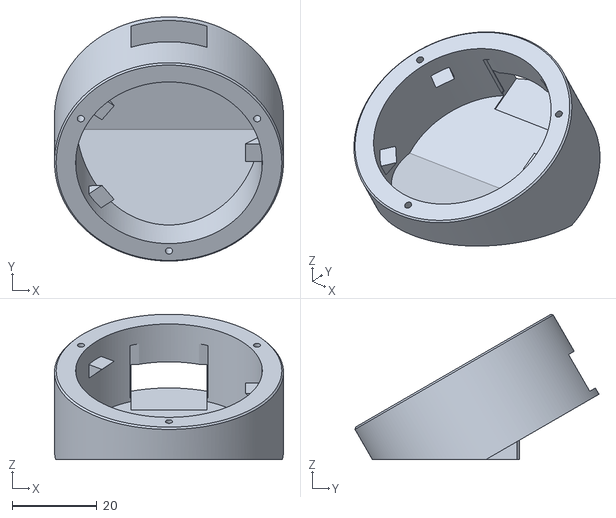
[picture p57: CAD file, 2026-11-11]
dotty-print-kit/body.stl
54.0 x 57.6 x 34.3
