trezm/dotty/cad/variants/m3-battery-disk/exports/base-disk.step

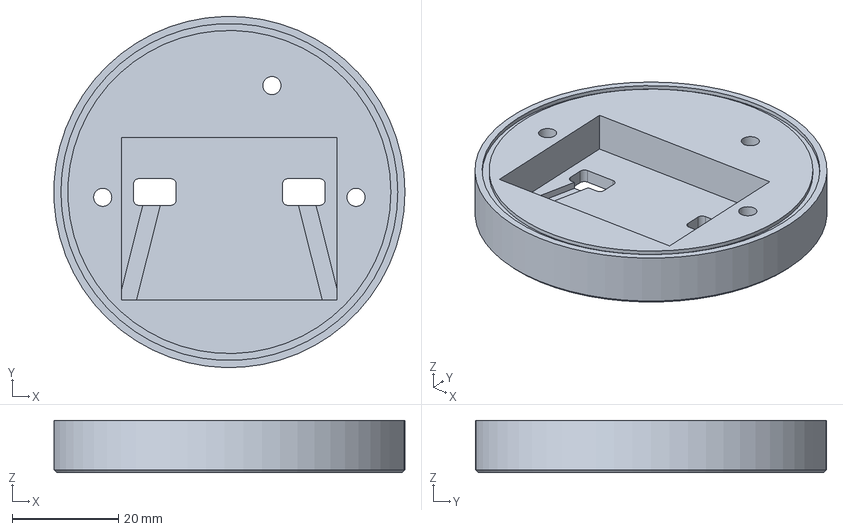
[picture p58: CAD file, 2026-11-11]
cad/variants/m3-battery-disk/exports/base-disk.step
66.0 x 66.0 x 9.80 mm
