trezm/dotty/cad/variants/m3-battery-40x30x8/exports/battery-cover.step

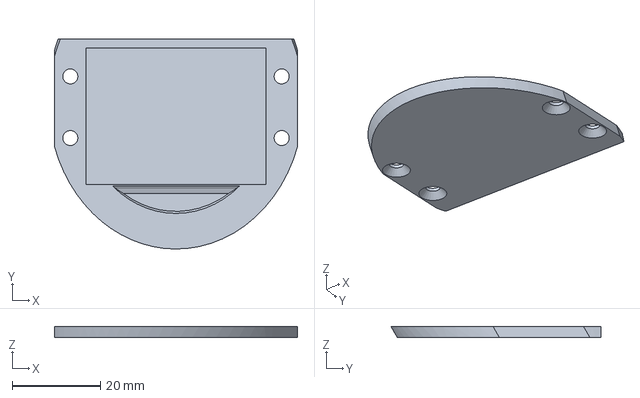
[picture p59: CAD file, 2026-11-11]
cad/variants/m3-battery-40x30x8/exports/battery-cover.step
55.2 x 47.7 x 2.40 mm
