trezm/dotty/cad/variants/m3-battery/exports/body.step

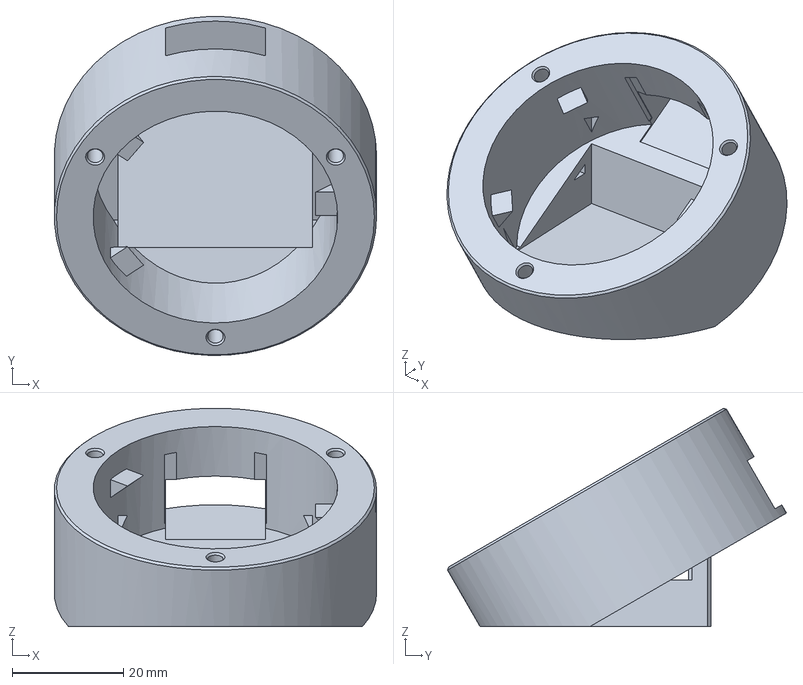
[picture p60: CAD file, 2026-11-11]
cad/variants/m3-battery/exports/body.step
58.0 x 61.0 x 39.3 mm
