trezm/dotty/(list of files, cad)

Other CAD files:
dotty-m3-battery 2/assembly.step
cad/variants/m3-machine/exports/fit-ring.step
dotty-m3/body.stl
dotty-print-kit/bezel.stl
cad/variants/m3-machine/exports/bezel.step
dotty-m3-battery 2/bezel.stl
dotty-m3-battery 3/fit-ring.stl
dotty-m3-battery/fit-ring.stl
dotty-m3/bezel.stl
cad/exports/body.step
cad/variants/m3-battery-40x30x8/exports/bezel.step
cad/variants/m3-battery/exports/fit-ring.step
cad/variants/m3-machine/exports/body.step
dotty-m3-battery 3/bezel.stl
dotty-m3-battery/bezel.stl
dotty-print-kit/fit-ring.stl
cad/variants/m3-battery-disk/exports/bezel.step
cad/variants/m3-machine/exports/fit-test.step
dotty-m3-battery 2/body.step
dotty-m3-battery 2/fit-ring.stl
cad/variants/m3-battery-disk/exports/fit-ring.step
dotty-m3-battery-disk/fit-ring.step
dotty-m3-battery-disk/bezel.step
cad/dotty-preview.blend
cad/exports/bezel.stl
cad/exports/fit-ring.stl
cad/variants/m3-battery-40x30x8/exports/battery-cover.stl
cad/variants/m3-battery-40x30x8/exports/bezel.stl
cad/variants/m3-battery-40x30x8/exports/body.stl
cad/variants/m3-battery-40x30x8/exports/fit-ring.stl
cad/variants/m3-battery-disk/exports/base-disk.stl
cad/variants/m3-battery-disk/exports/battery-cover.stl
cad/variants/m3-battery-disk/exports/countersink-fit.stl
cad/variants/m3-battery-disk/exports/fit-ring.stl
cad/variants/m3-battery-disk/exports/puck-body.stl
cad/variants/m3-battery/exports/bezel.stl
cad/variants/m3-battery/exports/body.stl
cad/variants/m3-battery/exports/fit-ring.stl
cad/variants/m3-machine/exports/bezel.stl
cad/variants/m3-machine/exports/body.stl
cad/variants/m3-machine/exports/fit-ring.stl
docs/color-studies-edgy/dotty-edgy-color-studies.blend
docs/color-studies-zed/dotty-zed-studies.blend
docs/color-studies/dotty-color-studies.blend
dotty-m3-battery 2/body.stl
dotty-m3-battery 3/body.stl
dotty-m3-battery-disk/base-disk.stl
dotty-m3-battery-disk/battery-cover.stl
dotty-m3-battery-disk/countersink-fit.stl
dotty-m3-battery-disk/fit-ring.stl
dotty-m3-battery-disk/puck-body.stl
dotty-m3-battery/body.stl
