trezm/dotty/docs/color-studies-edgy/01-hazard-draft.png

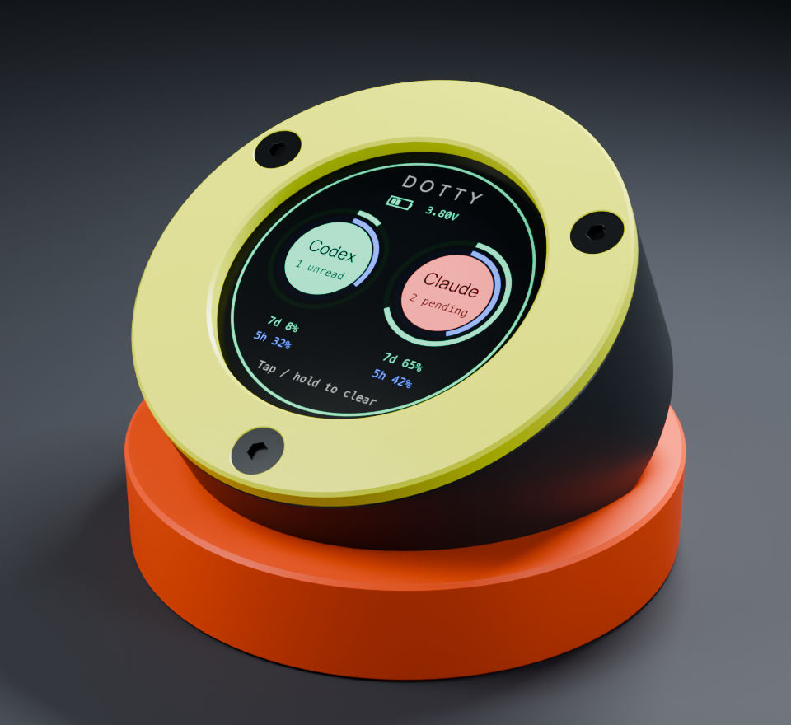
docs/color-studies-edgy/01-hazard-draft.png
