trezm/dotty/(commit log)

2026-11-11 Checkpoint Dotty hardware, firmware, companion, and design studies
    [assembly.step, base-disk.step, base-disk.stl, battery-cover.step, battery-cover.stl, bezel.step, bezel.stl, body.step]
2026-11-11 Prototype animated Codex and Claude eye gauges
2026-11-11 Add split-provider perimeter usage arcs to eye prototype
